amedes/ESP32TNC/BME280-APRS_memo-9.pdf

BME280-APRS メモ　Rev 1.9 2021.12.08

概要
・FX25-KISS-TNC に BME280 センサを接続し温湿度、気圧データを定期送信する。を接続し温湿度、気圧データを定期送信する。接続し温湿度、気圧データを定期送信する。し温湿度、気圧データを定期送信する。温湿度、気圧データを定期送信する。データを定期送信する。を接続し温湿度、気圧データを定期送信する。定期送信する。する。 TNC 内でアプリケーションを動作させ、測定データをでアプリケーションを動作させ、測定データをアプリケーションを接続し温湿度、気圧データを定期送信する。動作させ、測定データをさせ、測定データを定期送信する。を接続し温湿度、気圧データを定期送信する。 APRS 形式で送信する。でアプリケーションを動作させ、測定データを送信する。する。

ハードウエアの準備準備
・BME280 ユニットとと ESP32 ユニットと間を接続する。を接続し温湿度、気圧データを定期送信する。接続し温湿度、気圧データを定期送信する。する。
FX25-KISS-TNC 基板 Rev0.1 の準備 J3（18 極ピンヘッダ）を利用すると接続が容易。ピンヘッダ）を利用すると接続が容易。を接続し温湿度、気圧データを定期送信する。利用すると接続が容易。すると接続し温湿度、気圧データを定期送信する。が容易。容易。
BME280 | ESP32 | 基板 Rev0.1
SDI (SDA) | GPIO18 | J3-17
SCK (SCL) | GPIO19 | J3-16
VDD | 3v3 | J3-1
VIO | 3v3 | J3-1
CSB | 3v3 | J3-1
GND | GND | J3-3
SDO | GND | J3-3

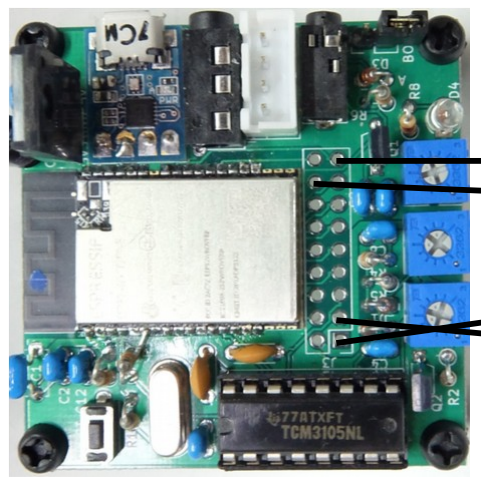
[picture p10: figure]

・基板 Rev0.3 を接続し温湿度、気圧データを定期送信する。使用すると接続が容易。する場合、GPIO18 = JP20、GPIO19 = JP19 を接続し温湿度、気圧データを定期送信する。利用すると接続が容易。し温湿度、気圧データを定期送信する。て BME280 と接 続し温湿度、気圧データを定期送信する。する。この準備場合 PTT 制御に使用できるに使用すると接続が容易。でアプリケーションを動作させ、測定データをきる GPIO ピンの準備選択肢が減ることに注意。が容易。減ることに注意。ることに注意。

・BME280 の準備 I2C アドレスはは 0x76（7bit アドレスは）を利用すると接続が容易。とすること。
（SDO=GND でアプリケーションを動作させ、測定データをアドレスは=0x76）を利用すると接続が容易。

ソフトとウエアの準備準備と実行
・KISS TNC ソフトとウエアを接続し温湿度、気圧データを定期送信する。入手する。する。
| リポジトとリは https://github.com/amedes/ESP32TNC

・menuconfig でアプリケーションを動作させ、測定データを ESP32 TNC Configuration を接続し温湿度、気圧データを定期送信する。選択する。

・使用すると接続が容易。するハードウエアに合わせた設定を行う。設定を接続し温湿度、気圧データを定期送信する。行う。

FX.25
TNC TRX

I2C

センサを接続し温湿度、気圧データを定期送信する。
(BME280)

APRS （温度 / 湿度 / 気圧データを定期送信する。）を利用すると接続が容易。

秋月のの準備 AE　BME280 モジュールの場合の準備場合 ・取説のの準備 I2C 接続し温湿度、気圧データを定期送信する。方法に従うに従うう
・ J1,　J2,　J3 は半田ジャンパ接続するジャンパ接続する接続し温湿度、気圧データを定期送信する。する (J3 接続し温湿度、気圧データを定期送信する。すればモジュールのモジュールの場合の準備 CSB 端子はは open でアプリケーションを動作させ、測定データをも可可 )

SDI
SCK
VDD
VIO
CSB
GND
SDO

BME280

対応ハードウエアハードウエア
・現状はは FX.25　KISS　TNC　Rev0.1　/　Rev0.3 に対応ハードウエア
・他のの準備 Rev の準備場合、機能に制限が生じる場合ありに制限が生じる場合ありが容易。生じる場合ありじる場合あり
・ M5Atom　Lite/Matrix 、 5StickC　Plus には近日対応ハードウエア予定

※特に に use ADC to get RXD state の準備設定に注意。

・menuconfig でアプリケーションを動作させ、測定データを BME280 APRS Configuration を接続し温湿度、気圧データを定期送信する。選択する。

・「BME280_EXISTS」を を接続し温湿度、気圧データを定期送信する。 y にする。 （ [＊]を接続し温湿度、気圧データを定期送信する。付ける ）ける ）を利用すると接続が容易。

・「BME280_INTERVAL」を 「BME280_MYCALL」を 「BME280_DSTCALL」を 「BME280_RPTCALL」を 「BME280_LAT」を 「BME280_LON」を を接続し温湿度、気圧データを定期送信する。設定する。

※ BME280_RPTCALL の準備デフォルの場合トと値は ”は ”WIDE1-1” 。 デジピータを定期送信する。設定が容易。不要な場合は場合は BME280_RPTCALL の準備内でアプリケーションを動作させ、測定データを容を接続し温湿度、気圧データを定期送信する。空欄とする。とする。 ”WIDE1-1,WIDE2-1”な場合はど２段デジピータの設定も可能。但しネットワークに輻輳など段デジピータの設定も可能。但しネットワークに輻輳などデジピータを定期送信する。の準備設定も可可能に制限が生じる場合あり。但しネットワークに輻輳などし温湿度、気圧データを定期送信する。ネットとワークに輻輳などに輻輳などな場合はど 生じる場合ありじな場合はいよう充分注意を接続し温湿度、気圧データを定期送信する。はらい設定すること。

・flash へ書き込み、書き込み、き込み、み、monitor を接続し温湿度、気圧データを定期送信する。起動する。

・起動後、BME280_INTERVAL でアプリケーションを動作させ、測定データを設定し温湿度、気圧データを定期送信する。た設定を行う。周期でアプリケーションを動作させ、測定データを APRS フレームが送信される。が容易。送信する。される。
| monitor 画面に温湿度、気圧データおよび送信パケットのに温湿度、気圧データを定期送信する。データを定期送信する。および送信パケットの送信する。パ接続するケットとの準備 16 進ダンプが表示される。ダンプが容易。表示される。される。

・APRS フレームが送信される。形式で送信する。は ”Lat/Long Position Report Format — without Timestamp” を接続し温湿度、気圧データを定期送信する。採用すると接続が容易。。 オプションの準備コメントと領域に温湿度、気圧データが配置される。に温湿度、気圧データを定期送信する。データを定期送信する。が容易。配置される。される。

以上
