amedes/ESP32TNC/KiCAD/m5stack-atom-tnc.sch

## KiCad design KiCAD/m5stack-atom-tnc.sch (2021-02-20)

Schematic: m5stack-atom-tnc.sch

Parts:
C1, C2, C3: 0.1u; C_Disc_D3.0mm_W1.6mm_P2.50mm
D1, D2: 1SS178; D_DO-34_SOD68_P2.54mm_Vertical_AnodeUp
D4: PTT; LED_D3.0mm_Clear
J1: Conn_01x05; PinHeader_1x05_P2.54mm_Vertical
J2, J5: Conn_01x04; PinHeader_1x04_P2.54mm_Vertical
J3: MJ-8435; Jack_3.5mm_MJ-8435_M5
J4: MJ-2-348B0; jack_2.5mm_MJ-2-348B0_M5
J6: Conn_01x08; PinHeader_1x08_P2.54mm_Vertical
JP1, JP2: Jumper_3_Open; SolderJumper-3_P1.3mm_Open_RoundedPad1.0x1.5mm_NumberLabels
JP3, JP4: Jumper_2_Open; SolderJumper-2_P1.3mm_Open_RoundedPad1.0x1.5mm
Q1: DTC143EL; TO-92S_Wide
R1: (VX8); R_Axial_DIN0204_L3.6mm_D1.6mm_P2.54mm_Vertical
R2: 120k; R_Axial_DIN0204_L3.6mm_D1.6mm_P2.54mm_Vertical
R3: 24k; R_Axial_DIN0204_L3.6mm_D1.6mm_P2.54mm_Vertical
R5: 100; R_Axial_DIN0204_L3.6mm_D1.6mm_P2.54mm_Vertical
R6: 1k; R_Axial_DIN0204_L3.6mm_D1.6mm_P2.54mm_Vertical
R7: 22k; R_Axial_DIN0204_L3.6mm_D1.6mm_P2.54mm_Vertical
RV1: 10k; BOURNS_3362P_M5

Notes on the sheet:
G22
G19
G23
G33
G21
G25
GND
3V3
JP1 JP2 JP3 JP4 ICOM 1-2 1-2 bridge open KENWOOD 2-3 2-3 open bridge
R7 Yaesu 4.7k Standard 22k ICOM 22k KENWOOD open
G26
G36
BAT
5V<-
for M5Atom
for M5StickC
