amedes/ESP32TNC/main/m5tnc_logo.c

/*
 * M5TNC logo
 */
#include <stdint.h>
#include "config.h"

#ifdef M5STICKC

const uint8_t m5tnc_logo[] = {
0xff, 0xd8, 0xff, 0xe0, 0x00, 0x10, 0x4a, 0x46, 0x49, 0x46, 0x00, 0x01, 0x01, 0x01, 0x00, 0x60, 
0x00, 0x60, 0x00, 0x00, 0xff, 0xdb, 0x00, 0x43, 0x00, 0x05, 0x03, 0x04, 0x04, 0x04, 0x03, 0x05, 
0x04, 0x04, 0x04, 0x05, 0x05, 0x05, 0x06, 0x07, 0x0c, 0x08, 0x07, 0x07, 0x07, 0x07, 0x0f, 0x0b, 
0x0b, 0x09, 0x0c, 0x11, 0x0f, 0x12, 0x12, 0x11, 0x0f, 0x11, 0x11, 0x13, 0x16, 0x1c, 0x17, 0x13, 
0x14, 0x1a, 0x15, 0x11, 0x11, 0x18, 0x21, 0x18, 0x1a, 0x1d, 0x1d, 0x1f, 0x1f, 0x1f, 0x13, 0x17, 
0x22, 0x24, 0x22, 0x1e, 0x24, 0x1c, 0x1e, 0x1f, 0x1e, 0xff, 0xdb, 0x00, 0x43, 0x01, 0x05, 0x05, 
0x05, 0x07, 0x06, 0x07, 0x0e, 0x08, 0x08, 0x0e, 0x1e, 0x14, 0x11, 0x14, 0x1e, 0x1e, 0x1e, 0x1e, 
0x1e, 0x1e, 0x1e, 0x1e, 0x1e, 0x1e, 0x1e, 0x1e, 0x1e, 0x1e, 0x1e, 0x1e, 0x1e, 0x1e, 0x1e, 0x1e, 
0x1e, 0x1e, 0x1e, 0x1e, 0x1e, 0x1e, 0x1e, 0x1e, 0x1e, 0x1e, 0x1e, 0x1e, 0x1e, 0x1e, 0x1e, 0x1e, 
0x1e, 0x1e, 0x1e, 0x1e, 0x1e, 0x1e, 0x1e, 0x1e, 0x1e, 0x1e, 0x1e, 0x1e, 0x1e, 0x1e, 0xff, 0xc0, 
0x00, 0x11, 0x08, 0x01, 0x40, 0x00, 0xf0, 0x03, 0x01, 0x11, 0x00, 0x02, 0x11, 0x01, 0x03, 0x11, 
0x01, 0xff, 0xc4, 0x00, 0x1c, 0x00, 0x01, 0x00, 0x02, 0x03, 0x01, 0x01, 0x01, 0x00, 0x00, 0x00, 
0x00, 0x00, 0x00, 0x00, 0x00, 0x00, 0x00, 0x06, 0x07, 0x04, 0x05, 0x08, 0x03, 0x02, 0x01, 0xff, 
0xc4, 0x00, 0x43, 0x10, 0x00, 0x01, 0x03, 0x03, 0x03, 0x01, 0x05, 0x04, 0x05, 0x07, 0x0b, 0x05, 
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
0x00, 0x00, 0x00, 0x00, 0x00, 0x00, 0x00, 0x00, 0x00, 0x00, 0x00, 0x00, 0x00, 0x00, 0x00, 0x00, 
0x00, 0x00, 0x00, 0x00, 0x00, 0x00, 0x00, 0x00, 0x00, 0x00, 0x00, 0x00, 0x00, 0x00, 0x00, 0x00, 
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
};

#endif
