amedes/ESP32TNC/main/tnc.h

/*
 * tnc.h
 * 
 * TNC control block
 */
#pragma once

#include <freertos/FreeRTOS.h>
#include <freertos/queue.h>
#include <freertos/task.h>
#include <freertos/semphr.h>
#include <freertos/ringbuf.h>

#include "config.h"
#include "filter.h"

//#define FX25TNCR2 1
//#define FX25TNCR3 1
//#define M5ATOM 1
//#define M5STICKC 1

#ifdef FX25_ENABLE
#include "fx25.h"
#endif

#ifdef M5ATOM
#include "m5atom.h"
#endif

#ifdef BK4802
#include "bk4802.h"
#endif

#if defined(FX25TNCR1)
#define TNC_PORTS 1
#define TCM3105_PORT 0  // port No. of TCM3105
#elif defined(FX25TNCR2)
#define TNC_PORTS 2 // number of ports
#elif defined(FX25TNCR3)
#define TNC_PORTS FX25TNCR3_PORTS // number of ports 1..6
#elif defined(FX25TNCR4)
#define TNC_PORTS 2
#elif defined(M5ATOM)
#define TNC_PORTS M5ATOM_PORTS	// 1..2
#elif defined(M5STICKC)
#define TNC_PORTS 1
#elif defined(BK4802)
#define TNC_PORTS 1
#else
#define TNC_PORTS 2 // number of ports 1..6
#endif

#if defined(ENABLE_TCM3105) && !defined(TCM3105_ADC)
#define SOFTMODEM_PORTS (TNC_PORTS - 1)
#else
#define SOFTMODEM_PORTS TNC_PORTS
#endif

#define BAUD_RATE 1200
#define DECODE_DELAY 4.458981479161393e-4 // sample delay
#define DELAY_DIVIDEND 325
#define DELAY_DIVISOR 728866

//#define SAMPLING_RATE 20184
//#define SAMPLING_RATE 13200
#define SAMPLING_RATE (1200*11)

#define DELAYED_N ((DELAY_DIVIDEND * SAMPLING_RATE + DELAY_DIVISOR/2) / DELAY_DIVISOR)

#if SAMPLING_RATE < 8000

#define FIR_BPF_N (5 * 4 - 1)
#define FIR_LPF_N (3 * 4 - 1)

#else

#define FIR_BPF_N (8 * 4 - 1)
#define FIR_LPF_N (8 * 4 - 1) // must be multiple of 4 minus 1

#endif


//#define DELAYED_N (int)(SAMPLING_RATE * DECODE_DELAY + 0.5)

#define AX25_FLAG 0x7e
#define DATA_LEN 1500
#define FX25_DATA_LEN 255

#define TCB_QUEUE_LENGTH (1024 * 2)
#define TCB_QUEUE_ITEM_SIZE sizeof(uint16_t)

#ifdef FX25_ENABLE
typedef struct FX25TAG fx25tag_t;
#endif

typedef struct TCB { // TNC Control Block
    //QueueHandle_t queue; // send data to modem
    RingbufHandle_t queue; // send data to modem
    RingbufHandle_t input_rb; // receive data from uart/tcp, ringbuffer nosplit
    TaskHandle_t task;
    
    uint8_t port; // port NO. 0 - 5
    uint16_t pkts;

    uint8_t state;
    uint8_t flag;
    uint8_t kiss_type; // indicate port number in upper nibble
    uint8_t data[DATA_LEN];
    int data_cnt;
    uint8_t data_byte;
    uint8_t data_bit_cnt;

#ifdef FX25_ENABLE
    // FX.25 variables
    uint8_t fx25_state;
    uint64_t fx25_tag;
    uint8_t fx25_data[FX25_DATA_LEN];
    int fx25_data_cnt;
    uint8_t fx25_data_byte;
    uint8_t fx25_data_bit_cnt;
    fx25tag_t const *fx25_tagp;
    // FX.25 parameter
    uint8_t fx25_parity; // 0: AX.25, >= 2: FX.25 number of parity bytes
    // AX.25 packet decode time
    uint32_t decode_time;
    // FX.25 Statistics
    uint16_t fx25_cnt_tag;
    uint16_t fx25_cnt_fx25;
    uint16_t fx25_cnt_fcs_err;
#endif

    // decode bit
    uint8_t pval;
    uint8_t nrzi;
    int adjust;

    // audio signal processing
    uint16_t avg;
    int avg_sum;

#define TCB_AVG_N 23

    uint16_t avg_buf[TCB_AVG_N];
    uint8_t avg_idx;
    int cdt_lvl;
    uint8_t cdt;
    int8_t cdt_led_pin;
    uint8_t cdt_led_on;
    SemaphoreHandle_t cdt_sem;

    // FSK decode
    uint8_t bit;

    // transmitter control
    volatile uint8_t ptt;
    int8_t ptt_pin;
    //QueueHandle_t mqueue; // modem queue

#ifdef FX25TNCR2 // only rev.2 has STA LED
    uint8_t sta_led_pin;
#endif

    // kiss parameter
    uint8_t SlotTime; // 10ms uint
    uint8_t TXDELAY; // 10ms uint
    uint8_t persistence_P; // P = p * 256 - 1
    uint8_t fullDuplex;

    // bell202 demodulator
    int delayed[DELAYED_N];
    int delay_idx;
    int x[FIR_LPF_N];
    int x_idx;

    // filter
    filter_t *bpf;
    filter_t *lpf;
    filter_t *avgf;

    // PLL
    int32_t pll_clock;

#ifdef ENABLE_TCM3105
    int pll_adj;
    uint32_t prev_ts;
    uint8_t enable_tcm3105; // enable TCM3105 for the port if true
    uint8_t cdt_off_timer;
#endif

#ifdef BK4802
    bk4802_t *bkp;
#endif
} tcb_t;

extern const uint8_t TNC_ADC_CH[];
extern tcb_t tcb[];

void tnc_init(tcb_t *tcb, int ports);
