amedes/ESP32TNC/components/BME280-APRS/include/BME280.h

/* i2c - Example

   For other examples please check:
   https://github.com/espressif/esp-idf/tree/master/examples

   See README.md file to get detailed usage of this example.

   This example code is in the Public Domain (or CC0 licensed, at your option.)

   Unless required by applicable law or agreed to in writing, this
   software is distributed on an "AS IS" BASIS, WITHOUT WARRANTIES OR
   CONDITIONS OF ANY KIND, either express or implied.
*/

/* 2021.03.04      ESP32 BME280 TNC  */
/* Made .h file from i2c-test source */

#include <stdio.h>
#include <string.h>
#include "esp_log.h"
#include "driver/i2c.h"
#include "sdkconfig.h"
#include "ax25.h"

#define BME280_APRS_PORT 0

#define _I2C_NUMBER(num) I2C_NUM_##num
#define I2C_NUMBER(num) _I2C_NUMBER(num)

#define I2C_MASTER_SCL_IO 19			/*!< gpio number for I2C master clock */
#define I2C_MASTER_SDA_IO 18			/*!< gpio number for I2C master data  */
#define I2C_MASTER_NUM I2C_NUM_0		/*!< I2C port number for master dev */
#define I2C_MASTER_FREQ_HZ 100000		/*!< I2C master clock frequency */
#define I2C_MASTER_TX_BUF_DISABLE 0             /*!< I2C master doesn't need buffer */
#define I2C_MASTER_RX_BUF_DISABLE 0             /*!< I2C master doesn't need buffer */

#define WRITE_BIT I2C_MASTER_WRITE              /*!< I2C master write */
#define READ_BIT I2C_MASTER_READ                /*!< I2C master read */
#define ACK_CHECK_EN 0x1                        /*!< I2C master will check ack from slave*/
#define ACK_CHECK_DIS 0x0                       /*!< I2C master will not check ack from slave */
#define ACK_VAL 0x0                             /*!< I2C ack value */
#define NACK_VAL 0x1                            /*!< I2C nack value */

#define BME280_ADDRESS 0x76

unsigned long int hum_raw,temp_raw,pres_raw;
signed long int t_fine;

uint16_t dig_T1;
 int16_t dig_T2;
 int16_t dig_T3;
uint16_t dig_P1;
 int16_t dig_P2;
 int16_t dig_P3;
 int16_t dig_P4;
 int16_t dig_P5;
 int16_t dig_P6;
 int16_t dig_P7;
 int16_t dig_P8;
 int16_t dig_P9;
 int8_t  dig_H1;
 int16_t dig_H2;
 int8_t  dig_H3;
 int16_t dig_H4;
 int16_t dig_H5;
 int8_t  dig_H6;


esp_err_t i2c_master_init(void);
void BME280_setup();
void BME280_aprs_task(void *arg);


void writeReg(uint8_t reg_address, uint8_t data);
void readData();
void readTrim();
signed long int calibration_T(signed long int adc_T);
unsigned long int calibration_P(signed long int adc_P);
unsigned long int calibration_H(signed long int adc_H);
