amedes/ESP32TNC/(commit log)

2021-02-20 initial release
    [m5stack-atom-tnc.sch]
2021-02-21 replace deprecated macro from I2S_COMM_FORMAT_I2S_MSB to I2S_COMM_FORMAT_STAND_I2S
    [i2s_adc.c]
2021-02-21 replace deprecated include file from esp_event_loop.h to eps_event.h
    [wifi.c]
2021-03-01 fixed compiling error for ESP-IDF v4.0
    [i2s_adc.c]
2021-03-05 fixed WiFi compiling error for ESP-IDF v4.0
    [i2s_adc.c, wifi.c]
2021-03-11 add FX.25 Forward Error Correction
    [config.h, decode.c, fx25.c, fx25.h, fx25_decode.c]
2021-03-13 fixed Buttom B malfunction caused by ESP32 ECO
    [m5stickc.c]
2021-03-28 fixed ADC sample interleaving for TNC_PORTS == 1
    [tnc.c]
2021-04-10 fixed do not send BME280 APRS packet bug
    [BME280.c]
2021-04-11 add reading TCM3105 RXD signal via I2S ADC
2021-04-13 add reading TCM3105 RXD via ADC support for FX.25 TNC rev.4
2021-04-14 fix compiling error for FX.25 TNC rev.3
    [tnc.c]
2021-04-17 rename the repository name from M5TNC to ESP32TNC
2021-04-18 add turning off DAC during receiving to prevent noise
    [timer.c]
2021-04-18 fix Wi-Fi UDP KISS connection malfunction
    [uart.c, wifi.c]
2021-04-19 fix sending zero length packet caused by UDP keepalive
    [fx25_decode.c, i2s_adc.c, kiss.c]
2021-04-19 add DAC off timer delay for PTT off time lag
2021-04-25 add accurate adc sample rate for 18kHz and 36kHz
2021-05-14 fixed bad wave form of software modem
    [timer.c]
2021-07-24 added ESP32-WROVER support, CDT4/5 redirect to CDT2/3
2021-08-14 fixed the typo FReeRTOS.h in FreeRTOS.h
    [kiss.c]
2021-11-21 fixed GPIO No. of TCM3105 TXD pin
    [timer.c]
2022-04-30 fixed esp-idf v4.4 API incompatibility
    [tcm3105.c]
2022-08-13 fixed BME280-APRS link error
    [BME280.c]
2023-07-13 fix BK4802 TX power configuration
    [bk4802.c]
